zhixuan2333/CH7800_EK/production/bom.csv

Designator | Footprint | Quantity | Value | LCSC Part #
C1, C2 | 0603 | 2 | 1u
IO1, IO2, IO3, IO4 | SW_PUSH_6mm | 4 | SW_Push
J1 | USB_C_Receptacle_Palconn_UTC16-G | 1 | USB_C_Receptacle_USB2.0_16P
J2 | PinHeader_1x02_P2.54mm_Vertical | 1 | Conn_01x02_Pin
J3 | PinHeader_1x07_P2.54mm_Vertical | 1 | Conn_01x07_Pin
R1, R2 | 0603 | 2 | 5.1k
SPEAKER1 | TerminalBlock_MaiXu_MX126-5.0-02P_1x02_P5.00mm | 1 | Speaker
U1 | SOT-23-6 | 1 | USBLC6-2SC6
U2 | SOIC-16_3.9x9.9mm_P1.27mm | 1 | CH7800
