zhixuan2333/CH7800_EK/CH7800_EK.kicad_pcb

## KiCad design CH7800_EK.kicad_pcb (2026-08-19)

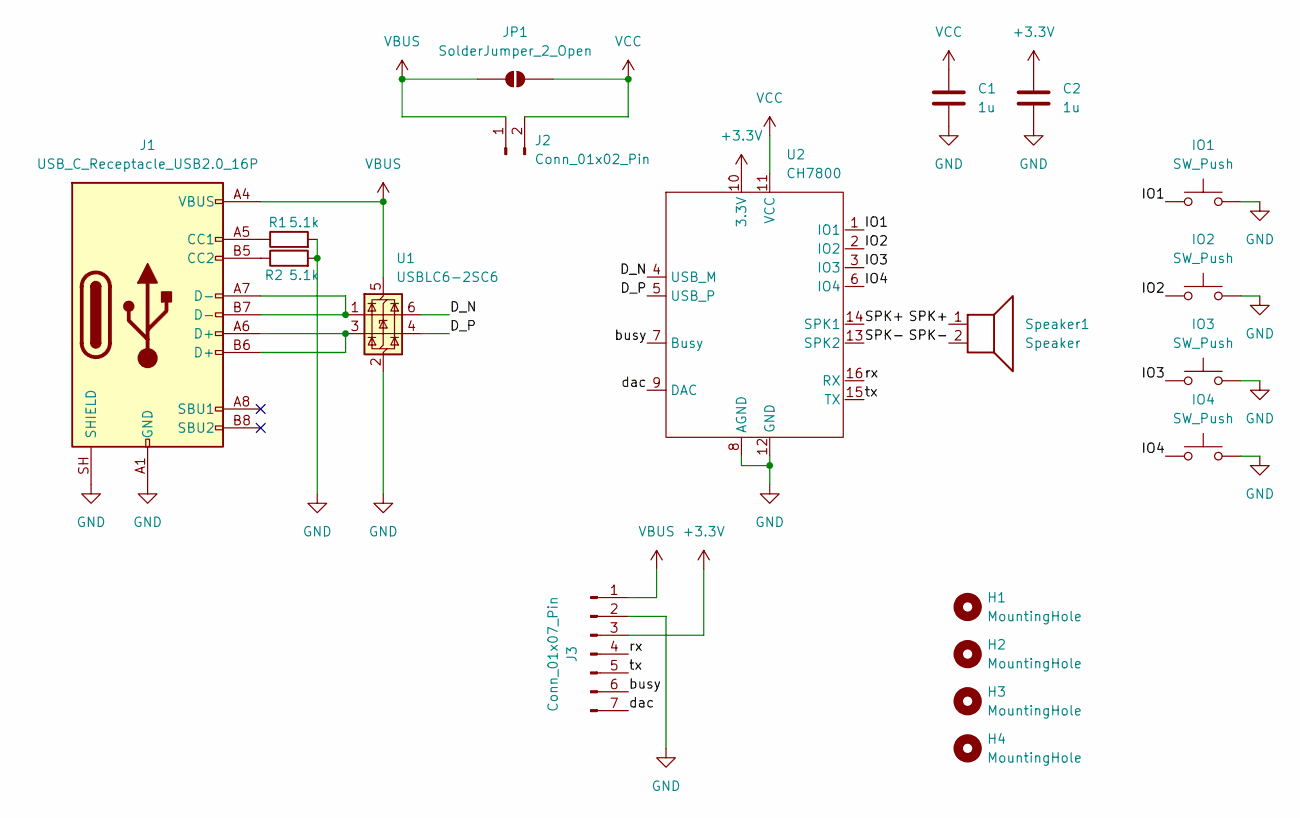
[picture p1: schematic CH7800_EK.kicad_sch]

Parts:
C1, C2: 1u; C_0603_1608Metric
H1, H2, H3, H4: MountingHole; MountingHole_3.2mm_M3
IO1, IO2, IO3, IO4: SW_Push; SW_PUSH_6mm
J1: USB_C_Receptacle_USB2.0_16P; USB_C_Receptacle_Palconn_UTC16-G
J2: Conn_01x02_Pin; PinHeader_1x02_P2.54mm_Vertical
J3: Conn_01x07_Pin; PinHeader_1x07_P2.54mm_Vertical
JP1: SolderJumper_2_Open; SolderJumper-2_P1.3mm_Open_RoundedPad1.0x1.5mm
R1, R2: 5.1k; R_0603_1608Metric
Speaker1: Speaker; TerminalBlock_MaiXu_MX126-5.0-02P_1x02_P5.00mm
U1: USBLC6-2SC6; SOT-23-6
U2: CH7800; SOIC-16_3.9x9.9mm_P1.27mm

Connections:
+3.3V: C2.1, J3.3, U2.10 (3.3V)
/D_N: U1.6 (I/O1), U2.4 (USB_M)
/D_P: U1.4 (I/O2), U2.5 (USB_P)
/IO1: IO1.1, U2.1 (IO1)
/IO2: IO2.1, U2.2 (IO2)
/IO3: IO3.1, U2.3 (IO3)
/IO4: IO4.1, U2.6 (IO4)
/SPK+: Speaker1.1, U2.14 (SPK1)
/SPK-: Speaker1.2, U2.13 (SPK2)
/busy: J3.6, U2.7 (Busy)
/dac: J3.7, U2.9 (DAC)
/rx: J3.4, U2.16 (RX)
/tx: J3.5, U2.15 (TX)
GND: C1.2, C2.2, IO1.2, IO2.2, IO3.2, IO4.2, J1.A1 (GND), J1.A12 (GND), J1.B1 (GND), J1.B12 (GND), J1.SH (SHIELD), J3.2, R1.2, R2.2, U1.2 (GND), U2.8 (AGND), U2.12 (GND)
unnamed: J1.A5 (CC1), R1.1
unnamed: J1.B5 (CC2), R2.1
unnamed: J1.A6 (D+), J1.B6 (D+), U1.3 (I/O2)
unnamed: J1.A7 (D-), J1.B7 (D-), U1.1 (I/O1)
VBUS: J1.A4 (VBUS), J1.A9 (VBUS), J1.B4 (VBUS), J1.B9 (VBUS), J2.1, J3.1, JP1.1 (A), U1.5 (VBUS)
VCC: C1.1, J2.2, JP1.2 (B), U2.11 (VCC)

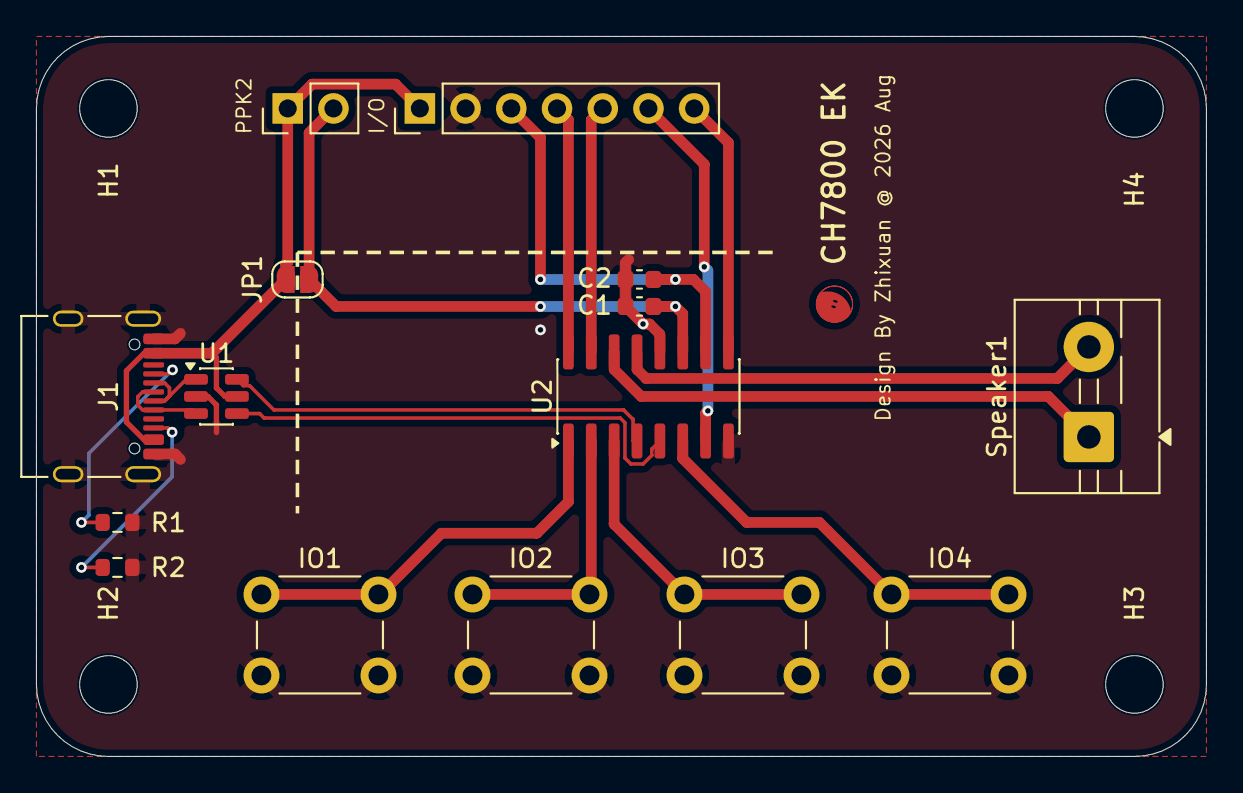
[picture p2: board CH7800_EK.kicad_pcb from above]

Board: 2 copper layers, 65.0 x 40.0 mm, 19 parts (0 on the bottom side), 20 nets.
