zhixuan2333/CH7800_EK/(commit log)

2026-08-09 CH7800 EK v1.0
    [CH7800_EK.kicad_pcb, CH7800_EK.kicad_sch]
2026-08-19 v1.1 with production file
    [CH7800_EK.kicad_pcb, CH7800_EK.kicad_sch, bom.csv, designators.csv, positions.csv]
2026-10-11 Add CH7800 UART TUI CLI and embedded protocol
2026-11-04 Add CH32V003 firmware: PIR-triggered random CH7800 playback (#1)
    * Add CH32V003 firmware that plays a CH7800 track over UART
    Bare-metal Rust firmware for CH32V003 driving the CH7800 EK via USART1
    (PD5 TX / PD6 RX, 9600 8N1) using the ch7800-protocol crate. It runs a
    UART self-test (version, file count, volume), plays track 2 at volume 7,
    and confirms playback with the BUSY pin on PA1 (idle high, low while
    playing). Results are kept in a DEBUG struct readable over SWD.
    Build for riscv32e+c: CH32V003 is RV32EC, and riscv32emc emitted mulhu,
    which trapped and silently restarted the MCU.
    * Play at full volume (30) now that VCC is powere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
